robsoncouto/gm328a_rev_eng/docs/lcd1.jpg

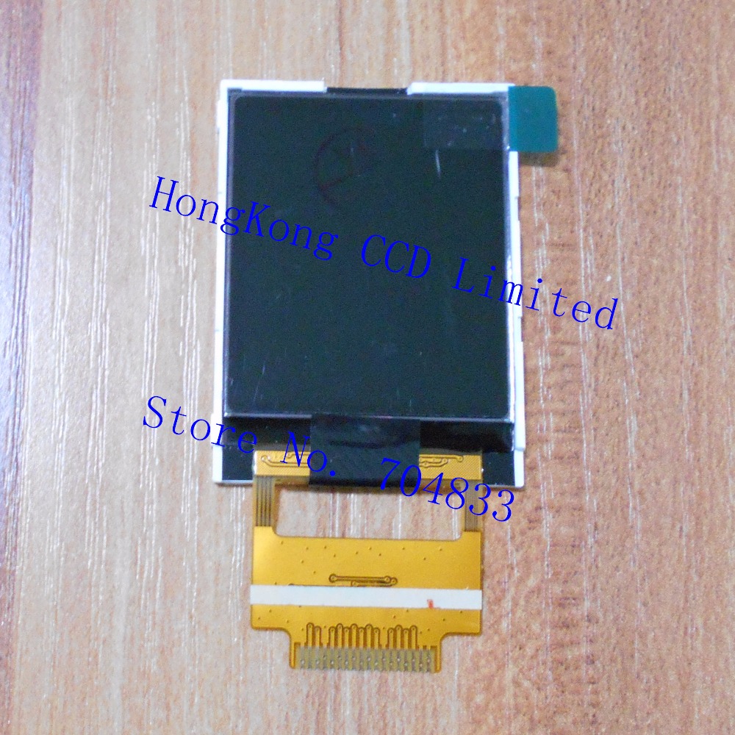
docs/lcd1.jpg
