robsoncouto/gm328a_rev_eng/docs/lcd2.jpg

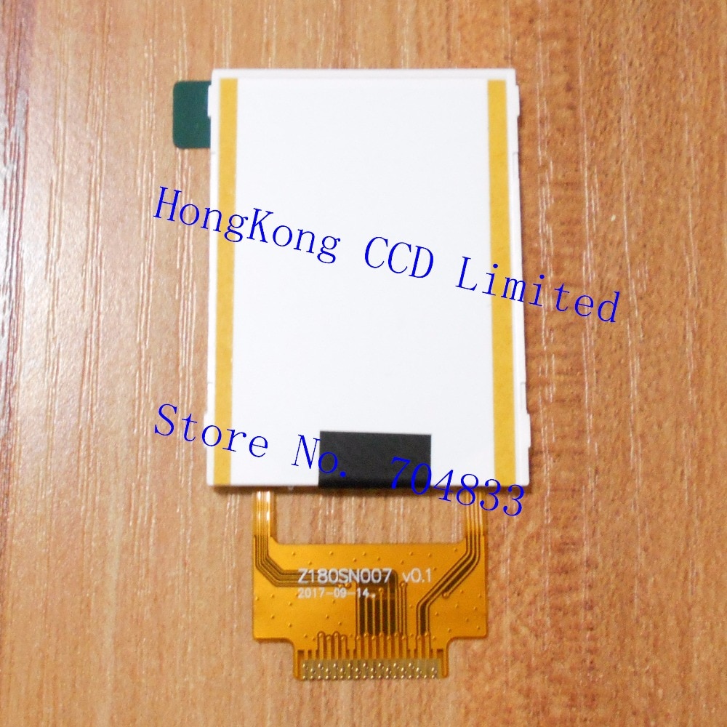
docs/lcd2.jpg
