robsoncouto/gm328a_rev_eng/README.md

# gm328a_rev_eng
Reverse engineering of the gm328a transistor tester
