robsoncouto/gm328a_rev_eng/docs/lcd3.jpg

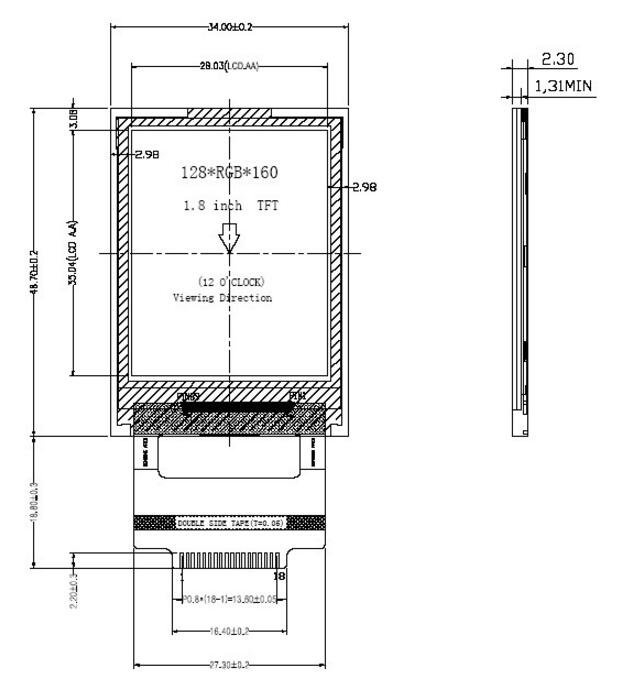
docs/lcd3.jpg
