robsoncouto/gm328a_rev_eng/docs/lcd4.jpg

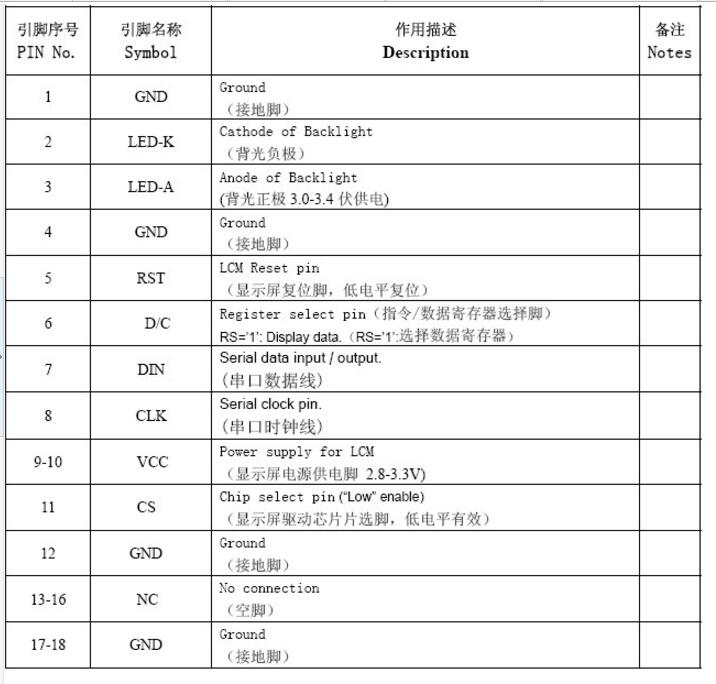
docs/lcd4.jpg
