robsoncouto/gm328a_rev_eng/schematics/display.png

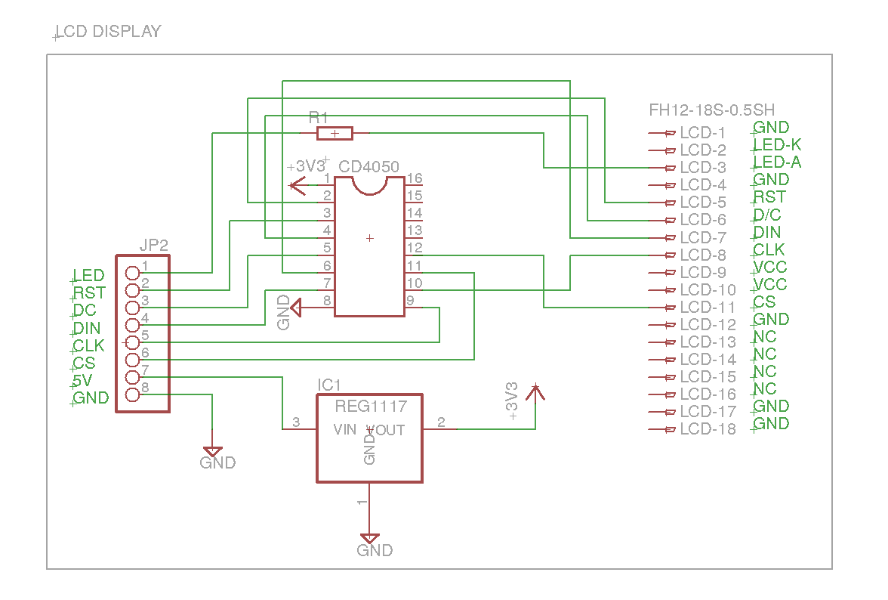
schematics/display.png
