robsoncouto/gm328a_rev_eng/schematics/sch2.png

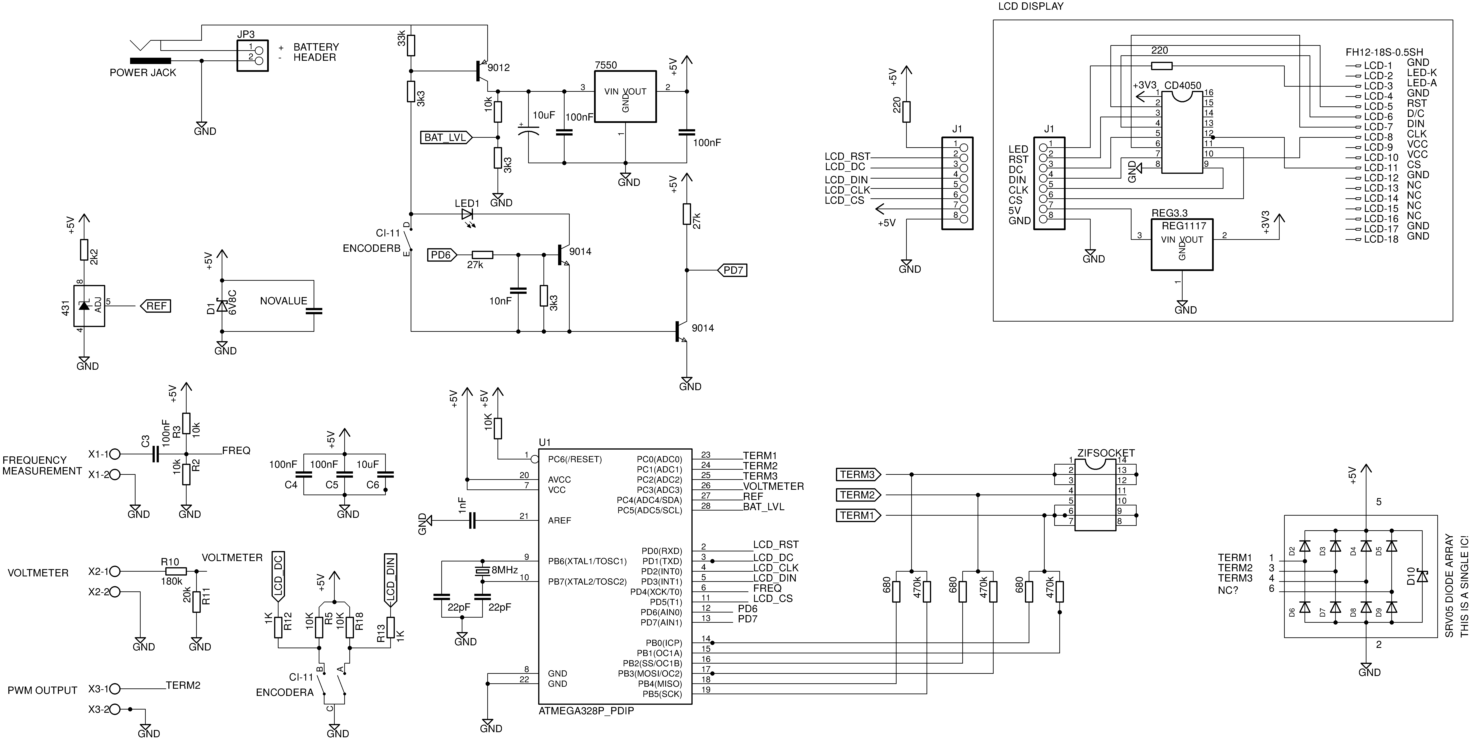
schematics/sch2.png
