robsoncouto/gm328a_rev_eng/(threads)

Thread 3 (2022-05-24):

Schematics correction (TL431)

Angel996, 2022-05-24:
Thanks for posting the schematics. There is a small correction. The cathode and REF pins of the TL431 must be shorted.
