robsoncouto/gm328a_rev_eng/schematics/gm328a.sch

## EAGLE design schematics/gm328a.sch (2019-04-17)

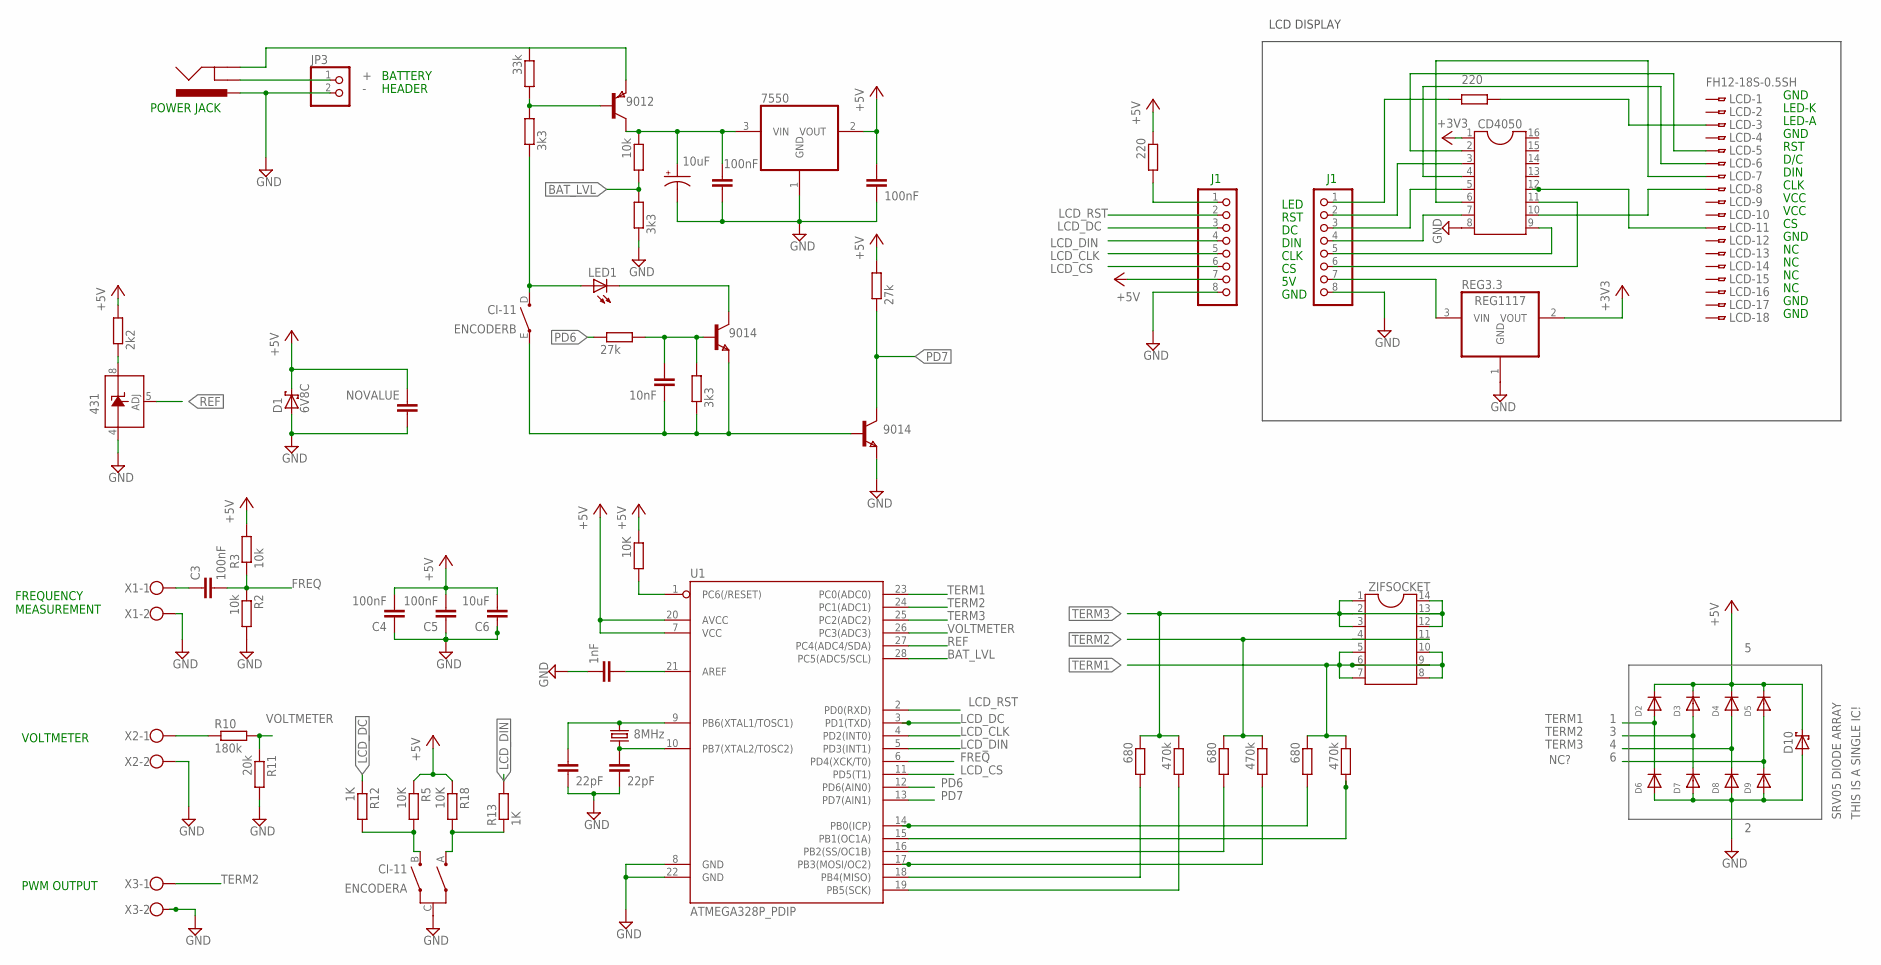
[picture p7: schematic gm328a.sch]

Parts:
1: 9014; SOT323
10K6: 10K; M0805
7550: REG1117; SOT223
9012: PNPSOT323; SOT323
9014: NPNSOT323; SOT323
C1, C2: 22pF; C0805
C3, C4, C5, C7, C9: 100nF; C0805
C6: 10uF; C0805
C8: 10uF; PANASONIC_C
C10: 10nF; C0805
C11: 1nF; C0805
C12: NOVALUE; C0805
CD4050: DIL16
D1: 6V8C; DO41-10
D2, D3, D4, D5, D6, D7, D8, D9: DIODE_SOD-123FL; SOD-123FL
D10: P4KEXX; DO41-10
ENCODER: CI-11
IC1: LM336D; SO08
J1: POWER_JACKSLT; POWER_JACK_SLOT
JP1, JP2: PINHD-1X8; 1X08
JP3: PINHD-1X2; 1X02
LCD: FH12-18S-0.5SH
LED1: LEDSML0805; SML0805
Q1: 8MHz; HC49/S
R1, R4: 220; M0805
R2, R3, R9: 10k; M0805
R5, R18: 10K; M0805
R6: 33k; M0805
R7, R8, R16: 3k3; M0805
R10: 180k; M0805
R11: 20k; M0805
R12, R13: 1K; M0805
R14: 2k2; M0805
R15, R17: 27k; M0805
R19, R21, R23: 680; M0805
R20, R22, R24: 470k; M0805
REG3.3: REG1117; SOT223
U1: ATMEGA328P_PDIP; DIL28-3
X1, X2, X3: W237-102
ZIFSOCKET: DIL14S; SOCKET-14

Connections:
+3V3: CD4050.1, REG3.3.2 (VOUT)
+5V: 10K6.1, 7550.2 (VOUT), C4.2, C5.2, C6.2, C9.1, C12.2, D1.C, D2.C, D3.C, D4.C, D5.C, D10.C, JP1.7, R3.2, R4.1, R5.1, R14.2, R17.2, R18.1, U1.7 (VCC), U1.20 (AVCC)
BAT_LVL: R8.2, R9.2, U1.28 (PC5(ADC5/SCL))
FREQ: C3.2, R2.1, R3.1, U1.6 (PD4(XCK/T0))
GND: 7550.1 (GND), 9014.3 (E), C1.2, C2.2, C4.1, C5.1, C6.1, C7.2, C8.-, C9.2, C11.1, C12.1, CD4050.8, D1.A, D6.A, D7.A, D8.A, D9.A, D10.A, ENCODER.C, IC1.4 (A), J1.PWR, JP1.8, JP2.8, JP3.2, R2.2, R8.1, R11.2, REG3.3.1 (GND), U1.8 (GND), U1.22 (GND), X1.2, X2.2, X3.2
LCD_CLK: JP1.5, U1.4 (PD2(INT0))
LCD_CS: JP1.6, U1.11 (PD5(T1))
LCD_DC: JP1.3, R12.1, U1.3 (PD1(TXD))
LCD_DIN: JP1.4, R13.2, U1.5 (PD3(INT1))
LCD_RST: JP1.2, U1.2 (PD0(RXD))
unnamed: JP2.7, REG3.3.3 (VIN)
unnamed: JP2.1, R1.1
unnamed: LCD.3, R1.2
unnamed: CD4050.3, JP2.2
unnamed: CD4050.5, JP2.3
unnamed: CD4050.7, JP2.4
unnamed: CD4050.9, JP2.5
unnamed: CD4050.11, JP2.6
unnamed: CD4050.2, LCD.5
unnamed: CD4050.4, LCD.6
unnamed: CD4050.6, LCD.7
unnamed: C2.1, Q1.2, U1.9 (PB6(XTAL1/TOSC1))
unnamed: CD4050.10, LCD.8
unnamed: CD4050.12, LCD.11
unnamed: C1.1, Q1.1, U1.10 (PB7(XTAL2/TOSC2))
unnamed: C3.1, X1.1
unnamed: 1.2 (B), C10.2, R15.2, R16.2
unnamed: ENCODER.B, R5.2, R12.2
unnamed: ENCODER.A, R13.1, R18.2
unnamed: J1.GND@1 (GNDBREAK), JP3.1
unnamed: ENCODER.D, LED1.A, R7.1
unnamed: JP1.1, R4.2
unnamed: 1.3 (E), 9014.2 (B), C10.1, ENCODER.E, R16.1
unnamed: 9012.2 (B), R6.2, R7.2
unnamed: 7550.3 (VIN), 9012.1 (C), C7.1, C8.+, R9.1
unnamed: R23.2, U1.14 (PB0(ICP))
unnamed: R24.2, U1.15 (PB1(OC1A))
unnamed: 1.1 (C), LED1.C
unnamed: R21.2, U1.16 (PB2(SS/OC1B))
unnamed: R22.2, U1.17 (PB3(MOSI/OC2))
unnamed: R19.2, U1.18 (PB4(MISO))
unnamed: R20.2, U1.19 (PB5(SCK))
unnamed: C11.2, U1.21 (AREF)
unnamed: 10K6.2, U1.1 (PC6(/RESET))
unnamed: IC1.8 (C), R14.1
unnamed: R10.1, X2.1
NC?: D5.A, D9.C
PD6: R15.1, U1.12 (PD6(AIN0))
PD7: 9014.1 (C), R17.1, U1.13 (PD7(AIN1))
POWER: 9012.3 (E), J1.GND@2 (GND), R6.1
REF: IC1.5 (ADJ), U1.27 (PC4(ADC4/SDA))
TERM1: D2.A, D6.C, R23.1, R24.1, U1.23 (PC0(ADC0)), ZIFSOCKET.5, ZIFSOCKET.6, ZIFSOCKET.7, ZIFSOCKET.8, ZIFSOCKET.9, ZIFSOCKET.10
TERM2: D3.A, D7.C, R21.1, R22.1, U1.24 (PC1(ADC1)), X3.1, ZIFSOCKET.4, ZIFSOCKET.11
TERM3: D4.A, D8.C, R19.1, R20.1, U1.25 (PC2(ADC2)), ZIFSOCKET.1, ZIFSOCKET.2, ZIFSOCKET.3, ZIFSOCKET.12, ZIFSOCKET.13, ZIFSOCKET.14
VOLTMETER: R10.2, R11.1, U1.26 (PC3(ADC3))

Notes on the sheet:
GND
LED-K
LED-A
RST
D/C
DIN
CLK
VCC
LED
LCD DISPLAY
431
SRV05 DIODE ARRAY
FREQUENCY MEASUREMENT
VOLTMETER
PWM OUTPUT
THIS IS A SINGLE IC!
BATTERY
HEADER
POWER JACK
