robsoncouto/gm328a_rev_eng/firmware 1.34/user.c

/* ************************************************************************
 *
 *   user interface functions
 *
 *   (c) 2012-2018 by Markus Reschke
 *
 * ************************************************************************ */


/*
 *  local constants
 */

/* source management */
#define USER_C


/*
 *  include header files
 */

/* local includes */
#include "config.h"           /* global configuration */
#include "common.h"           /* common header file */
#include "variables.h"        /* global variables */
#include "functions.h"        /* external functions */
#include "colors.h"           /* color definitions */


/*
 *  local constants
 */

/* rotary encoder */
#define DIR_NONE         0b00000000     /* no turn or error */
#define DIR_RESET        0b00000001     /* reset state */



/* ************************************************************************
 *   values and scales
 * ************************************************************************ */


/*
 *  get number of digits of a value
 */

uint8_t NumberOfDigits(uint32_t Value)
{
  uint8_t           Counter = 1;   /* return value */

  while (Value >= 10)
  {
    Value /= 10;
    Counter++;
  }

  return Counter;
}



/*
 *  compare two scaled values
 *
 *  requires:
 *  - first pair of value and scale
 *  - second pait of value and scale
 *
 *  returns:
 *  - -1 if first value is smaller than seconds one
 *  - 0 if equal
 *  - 1 if first value is larger than second one
 */

int8_t CmpValue(uint32_t Value1, int8_t Scale1, uint32_t Value2, int8_t Scale2)
{
  int8_t            Flag;               /* return value */
  int8_t            Len1, Len2;         /* length */

  /* determine virtual length */
  Len1 = NumberOfDigits(Value1) + Scale1;
  Len2 = NumberOfDigits(Value2) + Scale2;

  if ((Value1 == 0) || (Value2 == 0))    /* special case */
  {
    Flag = 10;                /* perform direct comparison */
  }
  else if (Len1 > Len2)       /* more digits -> larger */
  {
    Flag = 1;
  }
  else if (Len1 == Len2)      /* same length */
  {
    /* re-scale to longer value */
    Len1 -= Scale1;
    Len2 -= Scale2;

    while (Len1 > Len2)       /* up-scale Value #2 */
    {
      Value2 *= 10;
      Len2++;
      /* Scale2-- */
    }

    while (Len2 > Len1)       /* up-scale Value #1 */
    {
      Value1 *= 10;
      Len1++;
      /* Scale1-- */
    }   

    Flag = 10;                /* perform direct comparison */
  }
  else                        /* less digits -> smaller */
  {
    Flag = -1;
  }

  if (Flag == 10)             /* perform direct comparison */
  {
    if (Value1 > Value2) Flag = 1;
    else if (Value1 < Value2) Flag = -1;
    else Flag = 0;
  }

  return Flag;
}



/*
 *  rescale value
 *
 *  requires:
 *  - value and scale
 *  - new scale
 */

uint32_t RescaleValue(uint32_t Value, int8_t Scale, int8_t NewScale)
{
  uint32_t          NewValue;      /* return value */

  NewValue = Value;           /* take old value */

  while (Scale != NewScale)   /* processing loop */
  {
    if (NewScale > Scale)     /* upscale */
    {
      NewValue /= 10;
      Scale++;
    }
    else                      /* downscale */
    {
      NewValue *= 10;
      Scale--;
    }
  }

  return NewValue;
}



/* ************************************************************************
 *   user input 
 *   - test push button
 *   - rotary encoder
 *   - increase/decrease push buttons
 *   - touch screen
 * ************************************************************************ */


#ifdef HW_ENCODER 

/*
 *  read rotary encoder
 *  - adds delay of 0.5ms
 *  - encoder might be in parallel with LCD signal lines
 *
 *  returns user action:
 *  - KEY_NONE for no turn or invalid signal
 *  - KEY_RIGHT for right/clockwise turn
 *  - KEY_LEFT for left/counter-clockwise turn
 */

uint8_t ReadEncoder(void)
{
  uint8_t           Key = KEY_NONE;     /* return value */
  uint8_t           Temp;               /* temporary value */
  uint8_t           AB = 0;             /* new AB state */
  uint8_t           Old_AB;             /* old AB state */

  /* set encoder's A & B pins to input */
  Old_AB = ENCODER_DDR;                 /* save current settings */
//  ENCODER_DDR &= ~(1 << ENCODER_A);     /* A signal pin */
//  ENCODER_DDR &= ~(1 << ENCODER_B);     /* B signal pin */
  ENCODER_DDR &= ~((1 << ENCODER_A) | (1 << ENCODER_B));
  wait500us();                          /* settle time */

  /* get A & B signals */
  Temp = ENCODER_PIN;
  if (Temp & (1 << ENCODER_A)) AB = 0b00000010;
  if (Temp & (1 << ENCODER_B)) AB |= 0b00000001;

  /* restore port/pin settings */
  ENCODER_DDR = Old_AB;                 /* restore old settings */

  /* update state history */
  if (UI.EncDir == DIR_RESET)           /* first scan */
  {
    UI.EncState = AB;                   /* set as last state */
    UI.EncDir = DIR_NONE;               /* reset direction */
    UI.EncTicks = 0;                    /* reset time counter */
  }

  /* time counter */
  if (UI.EncTicks > 0)        /* after first pulse */
  {
    if (UI.EncTicks < 250)    /* prevent overflow */
    {
      UI.EncTicks++;          /* increase counter */
    }
  }

  Old_AB = UI.EncState;                 /* save last state */
  UI.EncState = AB;                     /* and save new state */

  /* process signals */
  if (Old_AB != AB)        /* signals changed */
  {
    /* check if only one bit has changed (Gray code) */
    Temp = AB ^ Old_AB;                 /* get bit difference */
    if (!(Temp & 0b00000001)) Temp >>= 1;
    if (Temp == 1)                      /* valid change */
    {
      /* determine direction */
      /* Gray code: 00 01 11 10 */
      Temp = 0b10001101;                /* expected values for a right turn */
      Temp >>= (Old_AB * 2);            /* get expected value by shifting */
      Temp &= 0b00000011;               /* select value */
      if (Temp == AB)                   /* value matches */
        Temp = KEY_RIGHT;               /* turn to the right */
      else                              /* value mismatches */
        Temp = KEY_LEFT;                /* turn to the left */

      /* step/detent logic */
      UI.EncPulses++;                   /* got a new pulse */

      if (Temp != UI.EncDir)            /* direction has changed */
      {     
        UI.EncPulses = 1;               /* first pulse for new direction */
        UI.EncTicks = 1;                /* enable time counter */
      }

      UI.EncDir = Temp;                 /* update direction */

      if (UI.EncPulses >= ENCODER_PULSES)    /* reached step */
      {
        UI.EncPulses = 0;               /* reset pulses */
        Key = Temp;                     /* signal valid step */
      }
    }
    else                                /* invalid change */
    {
      UI.EncDir = DIR_RESET;            /* reset direction state */
    }
  }

  return Key;
}

#endif



#ifdef HW_INCDEC_KEYS

/*
 *  check increase/decrease push buttons
 *  - adds delay of 0.5ms
 *  - buttons might be in parallel with LCD signal lines
 *  - speed-up functionality (similar to rotary encoder's turning velocity)
 *
 *  returns:
 *  - KEY_NONE for no button press
 *  - KEY_RIGHT for increase
 *  - KEY_LEFT for decrease
 *  - KEY_INCDEC for increase and decrease
 */

uint8_t ReadIncDecKeys(void)
{
  uint8_t           Key = KEY_NONE;          /* return value */
  uint8_t           RegState;                /* register state */
  uint8_t           Run = 1;                 /* loop control */
  uint8_t           Temp;                    /* temporary value */
  uint8_t           TicksInc = 0;            /* time counter */
  uint8_t           TicksDec = 0;            /* time counter */

  /* set pins to input */
  RegState = KEY_DDR;              /* save current settings */
  KEY_DDR &= ~((1 << KEY_INC) | (1 << KEY_DEC));
  wait500us();                     /* settle time */

  /* processing loop */
  while (Run == 1)
  {
    /* check push button state (low active) */
    Temp = KEY_PIN;                     /* get current state */
    Temp = ~Temp;                       /* invert bits */
    Temp &= (1 << KEY_INC) | (1 << KEY_DEC); /* filter buttons */

    if (Temp == 0)                 /* not button pressed */
    {
      Run = 0;                     /* end loop */
    }
    else                           /* button pressed */
    {    
      if (Temp & (1 << KEY_INC))   /* "increase" button */
      {
        TicksInc++;                /* increase counter */
      }

      if (Temp & (1 << KEY_DEC))   /* "decrease" button */
      {
        TicksDec++;                /* increase counter */
      }

      Temp = TicksInc + TicksDec;
      if (Temp >= 10)              /* long key press (300ms) */
      {
        Run = 2;                   /* end loop & signal long key press */
      }
      else
      {
        MilliSleep(30);            /* time to debounce and delay */
      }
    }
  }

  /* process counters */
  if (TicksInc > 0)                /* "increase" button pressed */
  {
    Key = KEY_RIGHT;
  }

  if (TicksDec > 0)                /* "decrease" button pressed */
  {
    if (Key == KEY_RIGHT)          /* also "increase" button */
    {
      Key = KEY_INCDEC;            /* both buttons pressed */
    }
    else                           /* just "decrease */
    {
      Key = KEY_LEFT;
    }
  }

  /* speed-up functionality */
  if (Key != KEY_NONE)             /* button pressed */
  {
    Temp = 1;                      /* default step size */

    if (Key == UI.KeyOld)          /* same key as before */
    {
      if (Run == 2)                /* long button press */
      {
        Temp = UI.KeyStepOld;      /* get former step size */

        if (Temp <= 6)             /* limit step size to 7 */
        {
          Temp++;                  /* increase step size */
        }
      }
    }

    UI.KeyStepOld = Temp;          /* update former step size */
    UI.KeyStep = Temp;             /* set new step size */
  }

  /* restore port/pin settings */
  KEY_DDR = RegState;              /* restore old settings */

  return Key;
}

#endif



#ifdef HW_TOUCH

/*
 *  check touch screen
 *
 *  returns:
 *  - KEY_NONE for no touch event
 *  - KEY_RIGHT for increase
 *  - KEY_LEFT for decrease
 */

uint8_t ReadTouchScreen(void)
{
  uint8_t           Key = KEY_NONE;          /* return value */
  uint8_t           OldKey = KEY_NONE;       /* former key action */
  uint8_t           Run = 1;                 /* loop control */
  uint8_t           Flag;                    /* control flag */
  uint8_t           n = 0;                   /* counter */
  uint8_t           X, Y;                    /* char pos */
  uint8_t           X_Max, Y_Max;            /* char pos limits */

  X_Max = UI.CharMax_X;       /* get limits */
  Y_Max = UI.CharMax_Y;

  /* processing loop */
  while (Run == 1)
  {
    Flag = Touch_Check();     /* check touch controller */

    if (Flag)                 /* touch event */
    {
      X = UI.TouchPos_X;      /* get char pos */
      Y = UI.TouchPos_Y;

      /* derive "button" */
      if (X <= 3)                  /* left touch bar */
      {
        Key = KEY_LEFT;
      }
      else if (X >= (X_Max - 2))   /* right touch bar */
      {
        Key = KEY_RIGHT;
      }
      else if (Y <= 2)             /* top touch bar */
      {
        Key = KEY_LEFT;
      }
      else if (Y >= (Y_Max - 1))   /* bottom touch bar */
      {
        Key = KEY_RIGHT;
      }
      else                         /* center area */
      {
        Key = KEY_SHORT;
      }

      /* control logic */
      if (Key == KEY_NONE)         /* no valid Key */
      {
        Run = 0;                   /* end loop */
      }
      else                         /* valid key */
      {
        if (OldKey == KEY_NONE)    /* first run */
        {
          OldKey = Key;            /* set former key */
        }

        if (OldKey != Key)         /* key has changed */
        {
          Key = KEY_NONE;          /* reset key */
          Run = 0;                 /* end loop */
        }
      }

      n++;                    /* increase counter */

      if (n >= 10)            /* long "button" press (300ms) */
      {
        Run = 2;              /* end loop & signal long press */
      }
      else                    /* */
      {
        MilliSleep(30);       /* time to debounce and delay */
      }
    }
    else                      /* no touch event */
    {
      Run = 0;                /* end loop */
    }
  }


  /* speed-up functionality */
  if (Key != KEY_NONE)             /* "button" pressed */
  {
    n = 1;                         /* default step size */

    if (Key == KEY_SHORT)          /* special case: center area */
    {
      if (Run == 2)                /* long key press */
      {
        Key = KEY_LONG;            /* change to long key press */
      }
    }
    else if (Key == UI.KeyOld)     /* same key as before */
    {
      if (Run == 2)                /* long button press */
      {
        n = UI.KeyStepOld;         /* get former step size */

        if (n <= 6)                /* limit step size to 7 */
        {
          n++;                     /* increase step size */
        }
      }
    }

    UI.KeyStepOld = n;             /* update former step size */
    UI.KeyStep = n;                /* set new step size */
  }

  return Key;
}

#endif



/*
 *  get user feedback
 *  - test push button
 *  - optional rotary encoder incl. detection of turning velocity
 *  - optional increase/decrease push buttons
 *  - optional touch screen
 *  - processing can be terminated by signaling OP_BREAK_KEY via Cfg.OP_Mode
 *    (e.g. set by an interrupt handler to deal with an infinite timeout)
 *
 *  requires:
 *  - Timeout in ms 
 *    0 = no timeout, wait for key press or any other feedback
 *  - Mode (bitmask):
 *    CURSOR_NONE     no cursor
 *    CURSOR_STEADY   steady cursor
 *    CURSOR_BLINK    blinking cursor
 *    UI_OP_MODE      consider tester operation mode (Cfg.OP_Mode)
 *
 *  returns:
 *  - KEY_TIMEOUT     reached timeout
 *  - KEY_SHORT       short press of test key
 *  - KEY_LONG        long press of test key
 *  - KEY_RIGHT       right key (e.g. rotary encoder turned right)
 *  - KEY_LEFT        left key (e.g. rotary encoder turned left)
 *  - KEY_INCDEC      increase and decrease keys both pressed
 *  The turning velocity (speed-up) is returned via UI.KeyStep (1-7).
 */

uint8_t TestKey(uint16_t Timeout, uint8_t Mode)
{
  uint8_t           Key = 0;       /* return value */
  uint8_t           Run = 1;       /* loop control */
  uint8_t           Ticks = 0;     /* time counter */
  uint8_t           Test;          /* temp. value */
  #ifdef HW_ENCODER
  uint8_t           Timeout2;      /* step timeout */
  uint8_t           Steps = 0;     /* step counter */
  uint8_t           MinSteps = 2;  /* required steps */
  uint16_t          Temp;          /* temp value */
  #endif


  /*
   *  init
   */

  #ifdef HW_ENCODER
    /* rotary encoder: sample each 2.5ms (1ms would be ideal) */
    #define DELAY_TICK   2         /* 2ms + 0.5ms for ReadEncoder() */
    #define DELAY_500    200       /* ticks for 500ms */
  #else
    /* just the test key */
    #define DELAY_TICK   5         /* 5ms */
    #define DELAY_500    100       /* ticks for 500ms */
  #endif

  #ifdef HW_ENCODER
  /* init variables for rotary encoder */
  UI.EncDir = DIR_RESET;      /* resets also UI.EncState and .EncTicks */
  UI.EncPulses = 0;
  Timeout2 = 50;
  #endif

  #ifdef HW_KEYS
  /* init variables for additional keys */ 
  UI.KeyStep = 1;             /* default level #1 */
  #endif

  if (Mode & UI_OP_MODE)           /* consider operation mode */
  {
    if (Cfg.OP_Mode & OP_AUTOHOLD)      /* auto hold mode */
    {
      Timeout = 0;                 /* disable timeout */
                                   /* and keep cursor mode */
    }
    else                                /* continous mode */
    {
      Mode = CURSOR_NONE;          /* disable cursor */
                                   /* and keep timeout */
    }
  }

  if (Mode & (CURSOR_STEADY | CURSOR_BLINK))  /* cursor enabled */
  {
    LCD_Cursor(1);            /* enable cursor on display */
  }


  /*
   *  wait for user feedback or timeout
   */
 
  while (Run)
  {
    /* take care about timeout */
    if (Timeout > 0)                    /* timeout enabled */
    {
      if (Timeout > 5) Timeout -= 5;    /* decrease timeout by 5ms */
      else Run = 0;                     /* end loop on timeout */
    }

    /*
     *  check for test push button
     *  - push button is low active
     */

    Test = CONTROL_PIN & (1 << TEST_BUTTON);   /* get button status */
    if (Test == 0)            /* if test button is pressed */
    {
      Ticks = 0;              /* reset counter */
      MilliSleep(30);         /* time to debounce */

      while (Run)             /* detect how long key is pressed */
      {
        Test = CONTROL_PIN & (1 << TEST_BUTTON);   /* get button status */
        if (Test == 0)        /* key still pressed */
        {
          Ticks++;                      /* increase counter */
          if (Ticks > 26) Run = 0;      /* end loop if 300ms are reached */
          else MilliSleep(10);          /* otherwise wait 10ms */
        }
        else                            /* key released */
        {
          Run = 0;                      /* end loop */
        }
      }

      /* determine key press type */
      if (Ticks > 26) Key = KEY_LONG;   /* long (>= 300ms) */
      else Key = KEY_SHORT;             /* short (< 300ms) */
    }
    else                      /* no key press */
    {
      /*
       *  touch screen
       */

      #ifdef HW_TOUCH
      Test = ReadTouchScreen();

      if (Test)               /* got user input */
      {
        Key = Test;                /* save key */
        break;                     /* exit loop */
      }
      #endif

      /*
       *  increase/decrease push buttons
       */

      #ifdef HW_INCDEC_KEYS
      Test = ReadIncDecKeys();

      if (Test)               /* got user input */
      {
        Key = Test;                /* save key */
        break;                     /* exit loop */
      }
      #endif

      /*
       *  rotary encoder
       */

      #ifdef HW_ENCODER
      Test = ReadEncoder();        /* read rotary encoder */

      if (Test)                    /* got user input */
      {
        if (Steps == 0)            /* first step */
        {
          Key = Test;              /* save direction */
        }

        if (Test == Key)           /* step in same direction */
        {
          Steps++;                 /* increase counter */

          /* calculate turning velocity */
          Test = UI.EncTicks / Steps;        /* ticks per step */
          Timeout2 += Test;                  /* add to timeout */
          Timeout2 += 3 * ENCODER_PULSES;    /* add some buffer */
          /* adjustment for steps/360°: *(steps/16) */
          Temp = Test * ENCODER_STEPS;
          Temp /= 16;
          Test = (uint8_t)Temp;
          /* velocity levels: 0 (fast) - 5 (slow) */
          if (Test > 40) Test = 40;          /* limit ticks */
          Test /= 8;                         /* get velocity level (0-5) */
          /* require 3 steps for high velocities */
          if (Test <= 2) MinSteps = 3;

          if (Steps == MinSteps)        /* got required steps */
          {
            /* reverse velocity level: 2 (slow) - 7 (fast) */
            UI.KeyStep = 7 - Test;      /* velocity level (2-7) */
            break;                      /* exit loop */
          }
        }
        else                       /* changed direction */
        {
          /* keep last direction and velocity level #1 */
          break;                   /* exit loop */
        }
      }

      if (Steps)                   /* after first step */
      {
        if (UI.EncTicks >= Timeout2)    /* timeout for velocity detection */
        {
          /* keep velocity level #1 */
          break;                        /* exit loop */
        }
      }
      #endif

      /*
       *  TTL serial
       */

      #ifdef SERIAL_RW
      if (Cfg.OP_Control & OP_RX_LOCKED)     /* buffer locked */
      {
        /* we received a command via the serial interface */
        Key = KEY_COMMAND;         /* remote command */
        break;                     /* exit loop */
      }
      #endif

      MilliSleep(DELAY_TICK);           /* wait a little bit */

      /*
       *  blinking cursor
       *  - HD44780's built-in blinking cursor is ugly anyway :)
       */
      
      if (Mode & CURSOR_BLINK)          /* blinking cursor */
      {
        Ticks++;                        /* increase counter */

        if (Ticks == DELAY_500)         /* every 500ms (1Hz) */
        {
          Ticks = 0;                    /* reset counter */

          /* we misuse Run as toggle switch */
          if (Run == 1)                 /* turn off */
          {
            LCD_Cursor(0);              /* disable cursor */
            Run = 2;                    /* toggle flag */
          }
          else                          /* turn on */
          {
            LCD_Cursor(1);              /* enable cursor */
            Run = 1;                    /* toggle flag */
          }
        }
      }
    }

    /* check if we should exit anyway */
    if (Cfg.OP_Control & OP_BREAK_KEY)  /* got break signal */
    {
      Cfg.OP_Control &= ~OP_BREAK_KEY;  /* clear break signal */
      break;                            /* exit loop */
    }
  }


  /*
   *  clean up
   */

  if (Mode & (CURSOR_STEADY | CURSOR_BLINK))  /* cursor enabled */
  {
    LCD_Cursor(0);            /* disable cursor on display */
  }

  #ifdef HW_KEYS
  UI.KeyOld = Key;            /* update former key */
  #endif

  #undef DELAY_500
  #undef DELAY_TICK

  return Key;
}



/*
 *  convenience version of TestKey() to wait for any user input or timeout
 *  based on the tester's operation mode
 */

void WaitKey(void)
{
  /* wait for key press or 3000ms timeout */
  TestKey(3000, CURSOR_STEADY | UI_OP_MODE);
}



/* ************************************************************************
 *   extra UI stuff
 * ************************************************************************ */


/*
 *  Tell user to create or remove short-circuit of all three probes 
 *  and wait until he really does. But allow user to abort creating
 *  a short circuit by a key press.
 *
 *  requires:
 *  - mode:
 *    0 = remove short-circuit
 *    1 = create short circuit
 *
 *  returns:
 *  - 0 on any problem
 *  - 1 on success
 */

uint8_t ShortCircuit(uint8_t Mode)
{
  uint8_t           Flag = 2;           /* return value / control flag */
  uint8_t           Test;               /* test feedback */
  uint8_t           Comp;               /* expected result */
  unsigned char     *String;            /* display string pointer */

  /* init */
  if (Mode == 0)         /* remove short */
  {
    String = (unsigned char *)Remove_str;
    Comp = 0;
  }
  else                   /* create short */
  {
    String = (unsigned char *)Create_str;
    Comp = 3;
  } 

  /* check if already done */
  Test = ShortedProbes();               /* get current status */
  if (Test == Comp)                     /* already done */
  {
    Flag = 1;                           /* skip loop */
  }
  else                                  /* not done yet */
  {
    /* tell user what to do */
    LCD_Clear();
    Display_EEString(String);             /* display: Remove/Create */
    Display_NextLine();
    Display_EEString(ShortCircuit_str);   /* display: short circuit! */
  }  

  /* wait until all probes are dis/connected */
  while (Flag == 2)
  {
    Test = ShortedProbes();        /* check for shorted probes */

    if (Test == Comp)              /* job done */
    {
       Flag = 1;                   /* end loop */
       MilliSleep(200);            /* delay to smooth UI */
    }
    else                           /* job not done yet */
    {
      Test = TestKey(100, CURSOR_NONE);      /* wait 100ms or for any key press */
      if (Mode == 1)                         /* short circuit expected */
      {
        if (Test > KEY_TIMEOUT) Flag = 0;    /* abort on key press */
      }
    }
  }

  return Flag;
}



#ifdef SW_CONTRAST

/*
 *  change LCD contrast
 *  - takes maximum value into account
 */

void ChangeContrast(void)
{
  uint8_t          Flag = 1;            /* loop control */
  uint8_t          Test = 1;            /* loop control */
  uint8_t          Contrast;            /* contrast value */
  uint8_t          Max;                 /* contrast maximum */
  

  /*
   *  increase: short key press / right turn 
   *  decrease: long key press / left turn
   *  done:     two brief key presses          
   */

  LCD_Clear();
  Display_EEString_Space(Contrast_str);      /* display: Contrast */

  Contrast = NV.Contrast;          /* get current value */
  Max = UI.MaxContrast;            /* get maximum value */

  while (Flag)
  {
    LCD_ClearLine2();
    Display_Value(Contrast, 0, 0);

    #ifdef HW_KEYS
    if (Flag < KEY_RIGHT)               /* just for test button usage */
    #endif
    MilliSleep(300);                    /* smooth UI */

    Flag = TestKey(0, CURSOR_NONE);     /* wait for user feedback */
    if (Flag == KEY_SHORT)              /* short key press */
    {
      MilliSleep(50);                   /* debounce button a little bit longer */
      Test = TestKey(200, CURSOR_NONE); /* check for second key press */
      if (Test > KEY_TIMEOUT)           /* second key press */
      {
        Flag = 0;                         /* end loop */
      }
      else                              /* single key press */
      {
        if (Contrast < Max) Contrast++;   /* increase value */
      }
    }
    #ifdef HW_KEYS
    else if (Flag == KEY_RIGHT)         /* rotary encoder: right turn */
    {
      if (Contrast < Max) Contrast++;   /* increase value */
    }
    #endif
    else                                /* long key press / left turn */
    {
      if (Contrast > 0) Contrast--;       /* decrease */
    }

    LCD_Contrast(Contrast);        /* change contrast */
  }
}

#endif



/* ************************************************************************
 *   menus
 * ************************************************************************ */


/*
 *  mark selected item
 *
 *  requires:
 *  - item: current item number (0-255)
 *  - selected: selected item number (0-255)
 */

void MarkItem(uint8_t Item, uint8_t Selected)
{
  if (Selected == Item)       /* current item selected */
  {
    #ifdef LCD_COLOR
    UI.PenColor = COLOR_MARKER;    /* change color */
    #endif
    Display_Char('*');             /* display asterisk */
    #ifdef LCD_COLOR
    UI.PenColor = COLOR_PEN;       /* reset color */
    #endif
  }
  else                        /* current item not selected */
  {
    Display_Space();               /* display space */
  }
}



/*
 *  menu tool
 *
 *  requires:
 *  - Items: number of menu items
 *  - Type: type of menu items
 *      1  pointer (in RAM) to fixed string stored in EEPROM
 *      2  uint16_t stored in EEPROM
 *  - Menu: address of array with menu items
 *  - Unit: optional fixed string stored in EEPROM
 *
 *  returns:
 *  - ID of selected item
 */

uint8_t MenuTool(uint8_t Items, uint8_t Type, void *Menu[], unsigned char *Unit)
{
  uint8_t           Selected = 0;       /* return value / ID of selected item */
  uint8_t           First = 0;          /* first item listed */
  uint8_t           Run = 2;            /* loop control flag */
  uint8_t           Lines;              /* line number */
  uint8_t           n;                  /* temp value */
  void              *Address;           /* address of menu element */
  uint16_t          Value;              /* temp. value */

  Items--;                    /* to match array counter */
  Lines = UI.CharMax_Y;       /* max. number of lines */
  Lines--;                    /* adjust to match item counter */
  Display_Char(':');          /* whatever: */


  while (Run)
  {
    if (Lines == 1)           /* 2 line display */
    {
      First = Selected;       /* just one line for items */
      Run++;                  /* set flag for changed list */
    }


    /*
     *  display item(s)
     */

    Address = &Menu[First];        /* get address of first item */
    n = 0;

    while (n < Lines)
    {
      LCD_CharPos(1, n + 2);       /* move to start of line */

      /* display indicator for multiline displays */
      if (Lines > 1)
      {
        MarkItem(First + n, Selected);
      }

      if (Run > 1)            /* list changed */
      {
        /* display item or value */
        if (Type == 1)                  /* fixed string */
        {
          Display_EEString(*(unsigned char **)Address);
        }
        else                            /* uint16_t in EEPROM */
        {
          Value = eeprom_read_word(Address); /* read value at eeprom address */
          Display_Value(Value, 0, 0);
        }     

        /* display optional fixed string */
        if (Unit)
        {
          Display_EEString(Unit);
        }  

        LCD_ClearLine(0);     /* clear rest of this line */
      }

      Address += 2;                /* next address (2 byte steps) */
      n++;                         /* next item */

      if (n > Items) n = Lines;    /* end loop for a short list */
    }

    Run = 1;             /* reset loop flag (changed list) */

    /* show navigation help for 2 line displays */
    if (Lines == 1)
    {
      LCD_CharPos(UI.CharMax_X, UI.CharMax_Y);    /* set position to bottom right */
      if (Selected < Items) n = '>';      /* another item follows */
      else n = '<';                       /* last item */
      Display_Char(n);
    }

    #ifndef HW_KEYS
      MilliSleep(100);        /* smooth UI */
    #endif


    /*
     *  process user feedback
     */
 
    n = TestKey(0, CURSOR_NONE);        /* wait for testkey */

    #ifdef HW_KEYS
    /* processing for rotary encoder etc. */
    if (n == KEY_SHORT)            /* short key press: select item */
    {
      n = KEY_LONG;                     /* trigger item selection */
    }
    else if (n == KEY_RIGHT)       /* rotary encoder: right turn */
    {
      n = KEY_SHORT;                    /* trigger next item */
    }
    else if (n == KEY_LEFT)        /* rotary encoder: left turn */
    {
      if (Selected == 0)                /* first item */
      {
        Selected = Items;               /* roll over to last item */

        if (Items >= Lines)             /* large list */
        {
          First = Items - Lines + 1;    /* update first item listed */
          Run++;                        /* set flag for changed list */
        }
      }
      else                              /* not first item */
      {
        Selected--;                     /* move to previous item */

        if (Selected == First)          /* item would be the first one listed */
        {
          if (Selected > 0)             /* more items in list */
          {
            First--;                    /* scroll one item down */
            Run++;                      /* set flag for changed list */
          }
        }
      }
    }
    #endif

    /* processing for testkey */
    if (n == KEY_SHORT)            /* short key press: move to next item */
    {
      if (Selected == Items)       /* last item */
      {
        Selected = 0;              /* roll over to first one */
        First = 0;                 /* also reset first item listed */

        if (Items >= Lines)        /* large list */
        {
          Run++;                   /* set flag for changed list */
        }
      }
      else                         /* more items follow */
      {
        Selected++;                /* move to next item */        

        n = First + Lines - 1;     /* last item on screen */
        if (Selected == n)         /* item would be the last one listed */
        {
          if (Items > Selected)    /* more items follow in list */
          {
            First++;               /* scroll one item up */
            Run++;                 /* set flag for changed list */
          }
        }
      }
    }
    else if (n == KEY_LONG)        /* long key press: select current item */
    {
      Run = 0;                     /* end loop */
    }
  }

  LCD_Clear();                /* feedback for user */
  MilliSleep(500);            /* smooth UI */

  return Selected;
}



/*
 *  adjustment menu
 */

void AdjustmentMenu(uint8_t Mode)
{
  #define MENU_ITEMS  3

  uint8_t           Item = 0;           /* item number */
  void              *MenuItem[MENU_ITEMS];   /* menu item strings */
  uint8_t           MenuID[MENU_ITEMS];      /* menu item IDs */
  uint8_t           ID;            /* profile ID */

  /* set up menu */
  MenuItem[Item] = (void *)Profile1_str;     /* profile #1 */
  MenuID[Item] = 1;
  Item++;  
  MenuItem[Item] = (void *)Profile2_str;     /* profile #2 */
  MenuID[Item] = 2;
  Item++;
  MenuItem[Item] = (void *)Exit_str;         /* exit menu */
  MenuID[Item] = 0;
  Item++;                                    /* add 1 for item #0 */

  /* display mode */
  LCD_Clear();
  if (Mode == STORAGE_SAVE)        /* write mode */
  {
    Display_EEString(Save_str);
  }
  else                             /* read mode */
  {
    Display_EEString(Load_str);
  }

  /* run menu */
  ID = MenuTool(Item, 1, MenuItem, NULL);    /* menu dialog */
  ID = MenuID[ID];                           /* get item ID */

  if (ID > 0)                 /* valid profile ID */
  {
    ManageAdjustmentStorage(Mode, ID);
  }

  #undef MENU_ITEMS
}


/*
 *  create main menu and return ID of selected item  
 */

uint8_t PresentMainMenu(void)
{
  #define ITEM_0         6         /* basic items */

  #if defined (SW_PWM_SIMPLE) || defined (SW_PWM_PLUS)
    #define ITEM_6       1
  #else
    #define ITEM_6       0
  #endif

  #ifdef SW_SQUAREWAVE
    #define ITEM_7       1
  #else
    #define ITEM_7       0
  #endif

  #ifdef HW_ZENER
    #define ITEM_8       1
  #else
    #define ITEM_8       0
  #endif

  #if defined (SW_ESR) || defined (SW_OLD_ESR)
    #define ITEM_9       1
  #else
    #define ITEM_9       0
  #endif

  #ifdef HW_FREQ_COUNTER
    #define ITEM_10      1
  #else
    #define ITEM_10      0
  #endif

  #ifdef SW_ENCODER
    #define ITEM_11      1
  #else
    #define ITEM_11      0
  #endif

  #ifdef SW_CONTRAST
    #define ITEM_12      1
  #else
    #define ITEM_12      0
  #endif

  #if defined (SW_IR_RECEIVER) || defined (HW_IR_RECEIVER)
    #define ITEM_13      1
  #else
    #define ITEM_13      0
  #endif

  #ifdef SW_OPTO_COUPLER
    #define ITEM_14      1
  #else
    #define ITEM_14      0
  #endif

  #ifdef SW_SERVO
    #define ITEM_15      1
  #else
    #define ITEM_15      0
  #endif

  #ifdef HW_TOUCH
    #define ITEM_16      1
  #else
    #define ITEM_16      0
  #endif

  #ifdef SW_IR_TRANSMITTER
    #define ITEM_17      1
  #else
    #define ITEM_17      0
  #endif

  #ifdef SW_DS18B20
    #define ITEM_18      1
  #else
    #define ITEM_18      0
  #endif

  #ifdef SW_CAP_LEAKAGE
    #define ITEM_19      1
  #else
    #define ITEM_19      0
  #endif

  #define MENU_ITEMS (ITEM_0 + ITEM_6 + ITEM_7 + ITEM_8 + ITEM_9 + ITEM_10 + ITEM_11 + ITEM_12 + ITEM_13 + ITEM_14 + ITEM_15 + ITEM_16 + ITEM_17 + ITEM_18 + ITEM_19)
//  #define MENU_ITEMS     19             /* worst case */

  uint8_t           Item = 0;           /* item number */
  uint8_t           ID;                 /* ID of selected item */
  void              *MenuItem[MENU_ITEMS];   /* menu item strings */
  uint8_t           MenuID[MENU_ITEMS];      /* menu item IDs */


  /*
   *  set up menu
   */

  /* extra items */
  #if defined (SW_PWM_SIMPLE) || defined (SW_PWM_PLUS)
  MenuItem[Item] = (void *)PWM_str;          /* PWM tool */
  MenuID[Item] = 6;
  Item++;
  #endif
  #ifdef SW_SQUAREWAVE
  MenuItem[Item] = (void *)SquareWave_str;   /* Square Wave Signal Generator */
  MenuID[Item] = 7;
  Item++;
  #endif
  #ifdef HW_ZENER
  MenuItem[Item] = (void *)Zener_str;        /* Zener tool */
  MenuID[Item] = 8;  
  Item++;
  #endif
  #if defined (SW_ESR) || defined (SW_OLD_ESR)
  MenuItem[Item] = (void *)ESR_str;          /* in-circuit ESR */
  MenuID[Item] = 9;
  Item++;
  #endif
  #ifdef SW_CAP_LEAKAGE
  MenuItem[Item] = (void *)CapLeak_str;      /* cap leakage */
  MenuID[Item] = 19;
  Item++;
  #endif
  #ifdef HW_FREQ_COUNTER
  MenuItem[Item] = (void *)FreqCounter_str;  /* frequency counter */
  MenuID[Item] = 10;
  Item++;
  #endif
  #ifdef SW_ENCODER
  MenuItem[Item] = (void *)Encoder_str;      /* rotary encoder check */
  MenuID[Item] = 11;
  Item++;
  #endif
  #if defined (SW_IR_RECEIVER) || defined (HW_IR_RECEIVER)
  MenuItem[Item] = (void *)IR_Detector_str;  /* IR RC detection */
  MenuID[Item] = 13;
  Item++;
  #endif
  #ifdef SW_IR_TRANSMITTER
  MenuItem[Item] = (void *)IR_Transmitter_str;    /* IR RC transmitter */
  MenuID[Item] = 17;
  Item++;
  #endif
  #ifdef SW_OPTO_COUPLER
  MenuItem[Item] = (void *)OptoCoupler_str;  /* opto coupler tool */
  MenuID[Item] = 14;
  Item++;
  #endif
  #ifdef SW_SERVO
  MenuItem[Item] = (void *)Servo_str;        /* servo check */
  MenuID[Item] = 15;
  Item++;
  #endif
  #ifdef SW_DS18B20
  MenuItem[Item] = (void *)DS18B20_str;      /* temperature sensor DS18B20 */
  MenuID[Item] = 18;
  Item++;  
  #endif

  /* standard items */
  MenuItem[Item] = (void *)Selftest_str;     /* selftest */
  MenuID[Item] = 1;
  Item++;
  MenuItem[Item] = (void *)Adjustment_str;   /* self-adjustment */
  MenuID[Item] = 2;
  Item++;
  #ifdef SW_CONTRAST
  MenuItem[Item] = (void *)Contrast_str;     /* LCD contrast */
  MenuID[Item] = 12;
  Item++;
  #endif
  #ifdef HW_TOUCH
  MenuItem[Item] = (void *)TouchSetup_str;   /* touch screen adjustment */
  MenuID[Item] = 16;
  Item++;
  #endif
  MenuItem[Item] = (void *)Save_str;         /* save self-adjustment values */
  MenuID[Item] = 3;
  Item++;
  MenuItem[Item] = (void *)Load_str;         /* load self-adjustment values */
  MenuID[Item] = 4;
  Item++;
  MenuItem[Item] = (void *)Show_str;         /* show self-adjustment values */
  MenuID[Item] = 5;
  Item++;
  MenuItem[Item] = (void *)Exit_str;         /* exit menu */
  MenuID[Item] = 0;


  /*
   *  run menu
   */

  LCD_Clear();
  Display_EEString(Select_str);              /* display "Select" */
  Item++;                                    /* add 1 for item #0 */
  ID = MenuTool(Item, 1, MenuItem, NULL);    /* menu dialog */
  ID = MenuID[ID];                           /* get item ID */

  return(ID);                 /* return item ID */

  #undef MENU_ITEMS
}



/*
 *  main menu
 */

void MainMenu(void)
{
  uint8_t           ID;                 /* ID of selected item */
  uint8_t           Flag = 1;           /* feedback flag */
  #ifdef SW_PWM_SIMPLE
  uint16_t          Frequency;          /* PWM frequency */  
  #endif

  ID = PresentMainMenu();     /* create menu and get user feedback */

  /* run selected item */
  switch (ID)
  {
    /* case 0:              exit menu */

    case 1:              /* self-test */
      Flag = SelfTest();
      break;

    case 2:              /* self-adjustment */
      Flag = SelfAdjustment();
      break;

    case 3:              /* save adjustment values */
      AdjustmentMenu(STORAGE_SAVE);
      break;

    case 4:              /* load adjustment values */
      AdjustmentMenu(STORAGE_LOAD);
      break;

    case 5:              /* show basic adjustment values */
      ShowAdjustmentValues();
      break;

    #ifdef SW_PWM_SIMPLE
    case 6:              /* PWM tool with simple UI */
      /* run PWM menu */
      LCD_Clear();
      Display_EEString(PWM_str);
      ID = MenuTool(NUM_PWM_FREQ, 2, (void *)PWM_Freq_table, (unsigned char *)Hertz_str);
      Frequency = eeprom_read_word(&PWM_Freq_table[ID]);    /* get selected frequency */
      PWM_Tool(Frequency);                                  /* and run PWM tool */
      break;
    #endif

    #ifdef SW_PWM_PLUS
    case 6:              /* PWM tool with improved UI */
      PWM_Tool();
      break;
    #endif

    #ifdef SW_SQUAREWAVE
    case 7:              /* square wave signal generator */
      SquareWave_SignalGenerator();
      break;
    #endif

    #ifdef HW_ZENER
    case 8:              /* Zener tool */
      Zener_Tool();
      break;
    #endif

    #if defined (SW_ESR) || defined (SW_OLD_ESR)
    case 9:              /* ESR tool */
      ESR_Tool();
      break;
    #endif

    #ifdef HW_FREQ_COUNTER
    case 10:             /* frequency counter */
      FrequencyCounter();
      break;
    #endif

    #ifdef SW_ENCODER
    case 11:             /* rotary encoder check */
      Encoder_Tool();
      break;
    #endif

    #ifdef SW_CONTRAST
    case 12:             /* change contrast */
      ChangeContrast();
      break;
    #endif

    #if defined (SW_IR_RECEIVER) || defined (HW_IR_RECEIVER)
    case 13:             /* IR RC detector/decoder */
      IR_Detector();
      break;
    #endif

    #ifdef SW_OPTO_COUPLER
    case 14:             /* opto coupler tool */
      OptoCoupler_Tool();
      break;
    #endif

    #ifdef SW_SERVO
    case 15:             /* servo check */
      Servo_Check();
      break;
    #endif

    #ifdef HW_TOUCH
    case 16:             /* touch screen adjustment */
      Flag = Touch_Adjust();
      break;
    #endif

    #ifdef SW_IR_TRANSMITTER
    case 17:             /* IR RC transmitter */
      IR_RemoteControl();
      break;
    #endif

    #ifdef SW_DS18B20
    case 18:             /* temperature sensor DS18B20 */
      DS18B20_Tool();
      break;
    #endif

    #ifdef SW_CAP_LEAKAGE
    case 19:             /* cap leakage */
      Cap_Leakage();
      break;
    #endif
  }

  /* display result */
  LCD_Clear();
  if (Flag == 0)
    Display_EEString(Error_str);   /* display: error! */
  else
    Display_EEString(Done_str);    /* display: done! */
}



/* ************************************************************************
 *   clean-up of local constants
 * ************************************************************************ */


/* source management */
#undef USER_C



/* ************************************************************************
 *   EOF
 * ************************************************************************ */
