robsoncouto/gm328a_rev_eng/(commit log)

2018-10-15 Added schematic and datasheets
2019-04-17 Updated schematics
    [gm328a.sch]
